jomigo96/SCDTR2018/Week3/sketch_oct11a/README.md

# script para medir com grande frequência a tensão no circuito do LDR

O valor medido vem em milivolts, corresponde à tensão da resistência. imprimem-se também o valor alimentado ao LED e o tempo em microsegundos.
