jomigo96/SCDTR2018/Week2/sketch_sep27a/README.md

# Rotina para imprimir a voltagem de dois LDRs

Imprime em mV. O circuito é um divisor de tensão, e no lab usámos a resistência de 100 Ohm.
