jomigo96/SCDTR2018/Week1/sketch_sep30a/README.md

# Rotina para usar um switch para ativar um led

A intensidade do led também é ajustável.

Feito no meu Arduino Mega, nos do lab as portas podem ser diferentes.
