jomigo96/SCDTR2018/Week1/sketch_sep27a/README.md

# Rotina para ler um valor do LDR.

## TODO

+ Determinar o valor da resistência através da tensão lida
+ Converter para lux
+ Calibrar para cada um dos LDRs
