jomigo96/SCDTR2018/Week1/sketch_sep27b/README.md

# Rotina para activar o LED com intensidade variável
