jomigo96/SCDTR2018/Report/preamble.tex

% -- Texto e codificação
\usepackage{anyfontsize}
\usepackage{pdflscape}

% -- Símbolos extra
\usepackage{amssymb}
\usepackage{textcomp}
\usepackage{gensymb}
\usepackage{cancel}

% -- Redefine margins
\geometry{top = 1cm}

% -- Bibliografia
\usepackage[
	backend = biber,
	style = alphabetic,
	sorting = ynt,
	%alldates=iso
	]{biblatex}
\usepackage{fvextra}
\usepackage{csquotes}

% --  Definições de imagens
\graphicspath{{graphics/}}
\usepackage{caption}
\usepackage{subcaption}
\usepackage{afterpage}
\usepackage{tabularx}

% -- Desenhar circuitos elétricos e lógicos
\usepackage{tikz}
\usepackage{pgfplots}
\usepackage{circuitikz}
\usetikzlibrary{arrows.meta,positioning,patterns,graphs}
\pgfplotsset{compat=1.15}
\pgfplotsset{table/search path = {data}}
\pgfplotsset{/pgf/number format/use comma,}

% -- Integrar código fonte
\usepackage{minted}
\usepackage{verbatim}
\usepackage{algorithm}
\usepackage{algpseudocode}

% -- Tabelas
\usepackage{booktabs}
\usepackage{makecell}

% -- Misc
\usepackage[disable]{todonotes}

% -- Funções matemáticas extra
\usepackage{siunitx}
\sisetup{
  math-ohm=\Omega,
  text-ohm=\ensuremath{\Omega},
}
