jomigo96/SCDTR2018/Week3/graphs/preamble.tex

% -- Language and text settings
\usepackage[portuguese]{babel}
\usepackage{microtype}
\usepackage{xcolor}

% -- Encoding and font
% \usepackage[utf8]{inputenc} -- Use XeLaTeX you dolt
% \usepackage[T1]{fontenc} -- Did I stutter?
% \usepackage{lmodern} -- No.
\usepackage{newpxtext,newpxmath}

% -- Document margins
\usepackage{geometry}
\geometry{verbose, nomarginpar,
    tmargin = 2.5cm,
    bmargin = 2.5cm,
    lmargin = 2.5cm,
    rmargin = 2.5cm}
% \usepackage{showframe}

% -- Bibliography
%\usepackage{csquotes}
%\usepackage{biblatex}
%\addbibresource{main.bib}

% -- Header and footer
\usepackage[bottom]{footmisc}
\usepackage{fancyhdr}
\fancyhf{}
\pagestyle{empty}%{fancy}
\fancyhead[L]{\textsc{Left Header}}
\fancyhead[C]{}
\fancyhead[R]{\thepage}
\fancyfoot[L]{}
\fancyfoot[C]{}
\fancyfoot[R]{}
\renewcommand{\headrulewidth}{0pt}
\renewcommand{\footrulewidth}{0pt}

% -- Extra math options
\usepackage{mathtools}
\usepackage{siunitx}

% -- Extra symbols
\usepackage{amssymb}
\usepackage{textcomp}
\usepackage{gensymb}
\usepackage{cancel}

% -- Links and references
\usepackage{hyperref}
\hypersetup{colorlinks,
	linkcolor	= {red!50!black},
	citecolor	= {green!30!black},
	urlcolor	= {blue!80!black}}

% --  Image and float settings
\usepackage{graphicx}
\graphicspath{{graphics/}}
\usepackage{caption}
\usepackage{subcaption}

% -- Graphs and diagrams
\usepackage{tikz}
\usepackage{pgfplots}
\usetikzlibrary{arrows.meta,positioning}
\pgfplotsset{compat=1.5, table/search path = {data}}
