jomigo96/SCDTR2018/Week4/README.md

# Controladores

Estes sketches consistem nos controladores para a dem. intermédia. São iguais, só mudam nos coeficientes dos LDRs que são diferentes.
