jomigo96/SCDTR2018/Week4/sketch_oct18a/README.md

# Modulo de controlo feed-forward + feedback

Em tudo igual ao outro script, mas com parametros diferentes na calibração do LDR. 
Como este LDR se partiu, este script está obsoleto até ser feita nova valibração.
