jomigo96/SCDTR2018/Week4/sketch_oct18a_2/README.md

# Modulo de controlo feed-forward + feedback

Para o LDR2, aquele que é mesmo do lab. O outro partiu-se.
