jomigo96/SCDTR2018/Week2/Calibracao/medidas.jpg

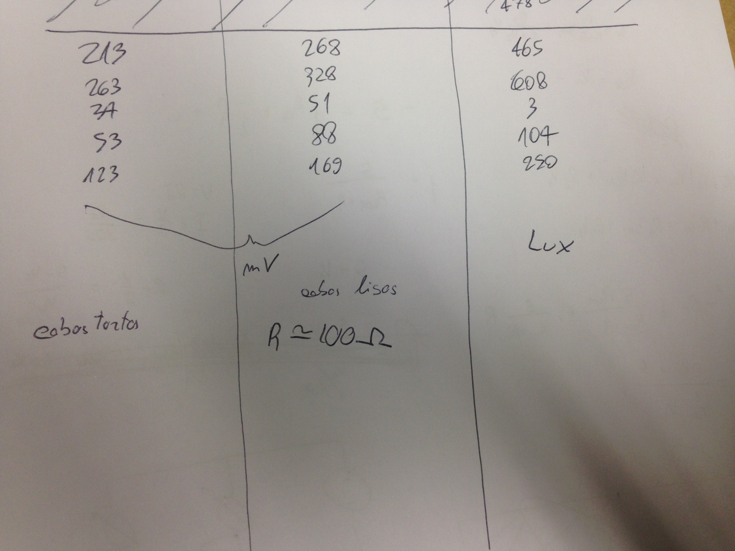
Week2/Calibracao/medidas.jpg
