jomigo96/SCDTR2018/(threads)

Thread 1 (2018-11-28):

Recalibrar LDR

jomigo96, 2018-11-28:
Um dos LDR está a medir as coisas muito mal.

jomigo96, 2018-12-08:
Re-callibrated by using the other one as a reference. Problem was a wrong resistor.

Closed 2018-12-08.
