jomigo96/SCDTR2018/Week3/graphs/main.pdf

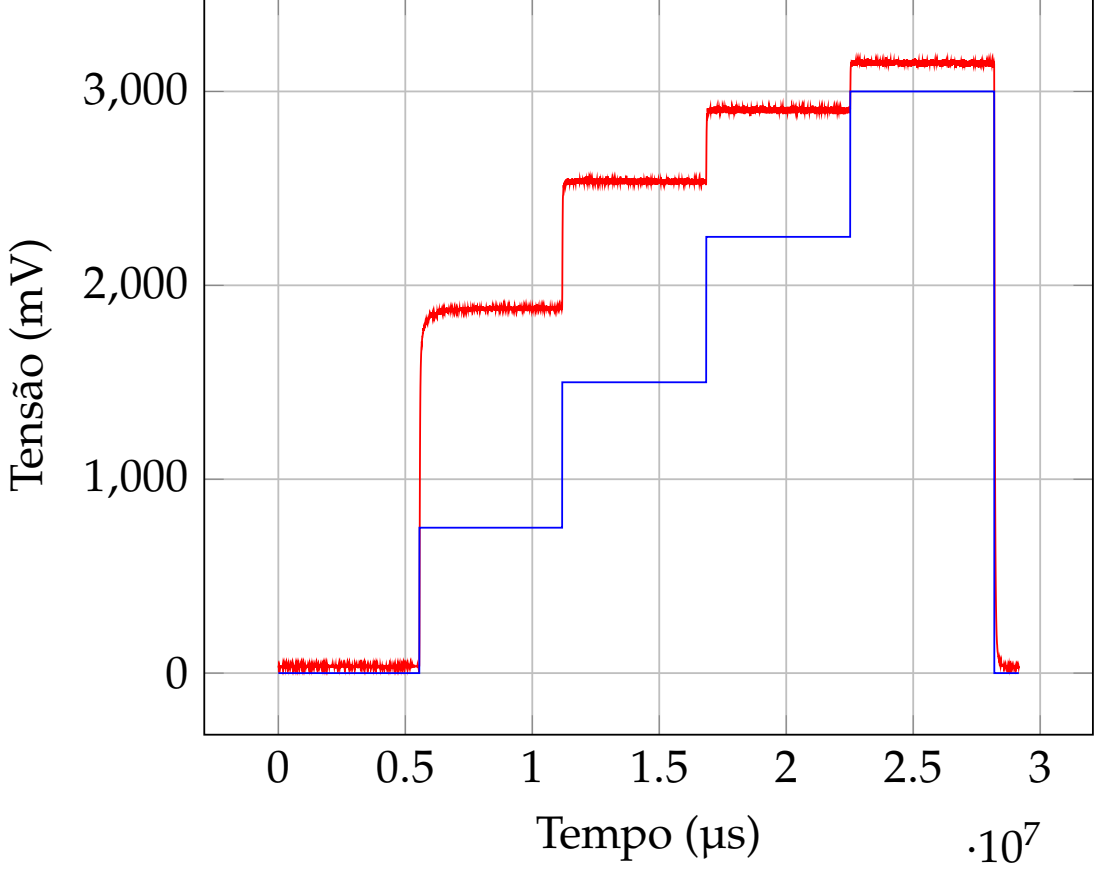
[picture p20: page 1]
Tempo (µs); Tensão (mV)
