jomigo96/SCDTR2018/Week6/c_version/slave.c

#include <stdio.h>
#include <pigpio.h>
#include <fcntl.h>
#include <sys/ioctl.h>
#include <linux/i2c-dev.h>
#define SLAVE_ADDR 0x48

int init_slave(bsc_xfer_t &xfer, int addr){
	gpioSetMode(18, PI_ALT3);
	gpioSetMode(19, PI_ALT3);
	xfer.control = (addr << 16) | /* Slave address */
	(0x00<<13) | /* invert transmit status flags */
	(0x00<<12) | /* enable host control */
	(0x00<<11) | /* enable test fifo */
	(0x00<<10) | /* invert receive status flags */
	(0x01<<9) | /* enable receive */
	(0x01<<8) | /* enable transmit */
	(0x00<<7) | /* abort and clear FIFOs */
	(0x00<<6) | /* send control reg as 1st I2C byte */
	(0x00<<5) | /* send status regr as 1st I2C byte */
	(0x00<<4) | /* set SPI polarity high */
	(0x00<<3) | /* set SPI phase high */
	(0x01<<2) | /* enable I2C mode */
	(0x00<<1) | /* enable SPI mode */
	0x01; /* enable BSC peripheral */
	return bscXfer(&xfer);
}

int close_slave(bsc_xfer_t &xfer){
	xfer.control = 0;
	return bscXfer(&xfer);
}

int main(int argc, char *argv[]){
	int status, j, key = 0;
	if (gpioInitialise() < 0){
		printf("Erro 1\n"); return 1;
	}
	
	bsc_xfer_t xfer;
	status = init_slave(xfer, SLAVE_ADDR);
	
	while(key != 'q'){
		xfer.txCnt = 0;
		status = bscXfer(&xfer);
		printf("Received %d bytes\n", xfer.rxCnt);
		for(j = 0; j < xfer.rxCnt; j++)
			printf("%c",xfer.rxBuf[j]);
		printf("\nPress q to quit.\n");
		key = getchar();
	}
	status = close_slave(xfer);
	gpioTerminate();
}
