jomigo96/SCDTR2018/(commit log)

2018-09-27 Ficheiros do primeiro laboratório
    Ficheiros utilizados no primeiro laboratório. Falta o 3º objectivo que
    era usar o valor do LDR para ajustara intensidade do LED.
2018-10-04 Ficheiros do lab 2
    Ficheiros da sessão 2. Tem a rotina que imprime valores em mV, e a tabela de valores de calibração.
    TODO: Converter e imprimir valores em LUX.
2018-10-04 Cálculo dos declives para o LDR
    Ver Readme em Week2/Calibracao
2018-10-12 Added preliminary graphs to Week3, needs scale fixing
    [data4.csv]
2018-10-13 Concluida a calibração dos LDRs
    Já se lê o valor em LUX, mas era importante testar com o sensor bom outra vez.
2018-10-22 Calculados ganhos e constantes de tempo
    Ver Readme
    [data4.csv]
2018-10-22 Added time constant calculations, edited report preamble
    [data.csv]
2018-10-24 Cleaning up for demo
    Ajustados os ganhos.
    Implementado um filtro mediano de 3 samples na leitura do LDR
    Ajustado o sampling time em função da temporização.
2018-11-11 Added c++ code
    Falta testar com os arduinos
    Tambem configurei o git no raspberry, estou a fazer o commit daÃ. SónÃo sei como dar net a partir do portÃtil, tenho usado wifi.
2018-11-13 Modificado codigo arduino para broadcast
2018-11-13 Codigo raspberry
2018-11-15 Codigo da ultima aula
    Está comentado, boa sorte.
    TODO:
    - Adaptar o código do raspberry (week6) para saber o que significam as
    mensagens. Para isso usar o mesmo struct que os arduinos.
    - Incluir esquema de calibração, "consensus" acho eu.
    - Incluir o controlador PI (week4)
2018-11-22 arquitetura de calibracao
2018-11-22 Algoritmo de calibracao implementado
    Falta testar obvio.
    Pode haver um problema ao usar volatile e memcpy
    [sketch_nov15a.ino]
2018-11-26 Calibration tested
    A funcionar mais ou menos
2018-11-28 Refactored the calibration script
    Modularized Arduino code, into communications, controller and
    calibration.
    Defined the message struct (see comms.h) to have 32 bytes,
    which is the maximum supported by the Wire library.
    Next improvement will be a timeout for when the calibration is stuck.
    Controller consists of a C++ class (to be developed), for now it just has the method compute_lux() to easily convert sensor value to LUX.
    [calibration.h, comms.h, controller.h, sketch_nov15a.ino]
2018-11-28 Wrote report section for calibration
    Nao se espumem com os todos, se quiserem o relatorio limpo editem o
    preamble.tex para \usepackage[disable]{todolist}.
    O Schiffart vai ter de fazer aquele diagrama em tikz, rip.
2018-11-29 Patched calibration
2018-12-08 Integrated PID controller with calibration
    Class Controller now has the actual PID controller from the first Demo.
    Also re-callibrated an LDR, using the other one as a reference. Problem
    was a resistor was 16k while it needed to be 10k.
    Defined a macro for settling which node is which.
    TODO: Implement Consensus
    [calibration.h, comms.h, consensus_arduino.ino, controller.h, sketch_dec06a.ino]
2018-12-09 Consensus in progress
    Implemented consensus by adapting the Matlab code. There are a few
    issues because in the .m script, dimming values are 1-100, and in the
    Arduino implementation, they are 0-1.0.
    Defined new macros for better debugging.
    [comms.h, controller.h, sketch_dec06a.ino]
2018-12-10 Added I2C input structure
2018-12-12 Matlab implementation with arduino logic, bug in consensus found
2018-12-12 Consensus working almost perfectly
    I converges as long as node 2 starts the calibration, and sometimes if
    it is node 1 that starts, it oscilates forever. I have no idea why.
2018-12-13 Consensus working almost flawlessly
    Defined new High and Low lux values
    Defined new message codes
    Implemented a push button with debouncer to toggle desk states
    No bus clashes encountered this time
    Sometimes on a lower bound change, the consensus doesn't converge :(
    [comms.h, controller.h, sketch_dec06a.ino]
2018-12-13 Fixed server parsing errors
    [server.cpp]
2018-12-14 Arduino code ready for shipping
    Consensus works well now.
    Added a feature that resets the integral term if a new dimming is
    desired.
    Still, there is an issue, if there is a heavy disturbance, the feedback
    controller will compensate too much on actuation, such that the optimal
    dimmings won't be restored when the disturbance goes away.
    [calibration.h, comms.h, controller.h, sketch_dec06a.ino]
2018-12-17 Raspberry dev
2018-12-17 problems reading big messages
    [main.cpp]
2018-12-31 Changes done in the lab Minor changes, callibration waiting period shortened, message template size
    [calibration.h, comms.h]
2019-01-05 Arduino code commented
    Comment arduino code doxygen-style.
2019-01-06 Commented Server code
    No actual changes to the server code apart from documentation.
    Text wraps to 80 char with the exception of Session.cpp.
    TODO: fix data streamming, thread sends back a sample everytime
    ANY node data is received.
    [Server.cpp, Server.hpp, Session.cpp, Session.hpp, main.cpp]
2019-01-10 Report backup
    Report is being developed on overleaf.
    Other minor changes
    [data4.csv]
2019-01-11 Changes to arduino code to measure some data
    Data gathered for documenting first stage, see directory data and the
    README inside
    [computation_time.csv, feedback.csv, feedforward.csv, feedforward_feedback.csv, jitter_simple_processed.csv, jitter_single.csv, no_pwm_change.csv, nyquist.csv]
2019-01-11 Patch controller gains
    Changes controller gains for better performance, and fixes a
    mathematical issue on the integrator formula.
    [controller.h]
2019-01-12 Process data for plotting
    [antiwindup.csv, feedback.csv, feedforward.csv, feedforward_feedback.csv, windup.csv]
2019-01-12 Fixes streamming and sets new pwm frequency
    [Session.cpp, Session.hpp, main.cpp, sketch_dec06a.ino]
2019-01-12 Patched a bug on server code
    [main.cpp]
2019-01-12 Processed data for report
    [stream2.csv]
2019-01-14 Finish final report
    Final report source files from Overleaf, updates readme, adds license.
    [antiwindup.csv, data4_simple.csv, feedback.csv, feedforward.csv, feedforward_feedback.csv, i2ctiming.csv, no_pwm_change.csv, stream2.csv]
